rejunity/tt10-lgn-mnist/assets/final_20250113-141316_acc4865_seed775741_epochs50_dispersion16_8x1024.png

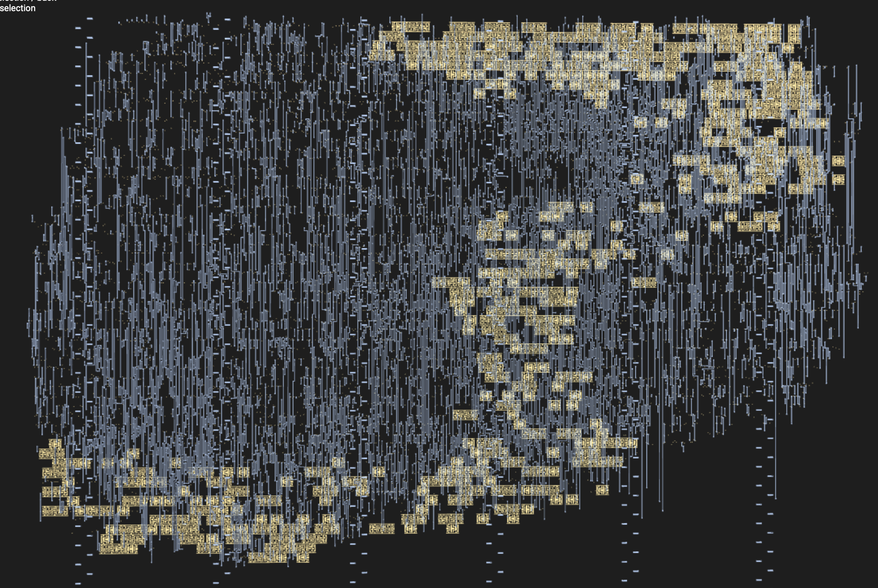
assets/final_20250113-141316_acc4865_seed775741_epochs50_dispersion16_8x1024.png
