rejunity/tt10-lgn-mnist/assets/final_20250114-102550_acc8068_seed1873_epochs300_dispersion64_1020-1020-1020-1020-1020-1020-1020-1020.png

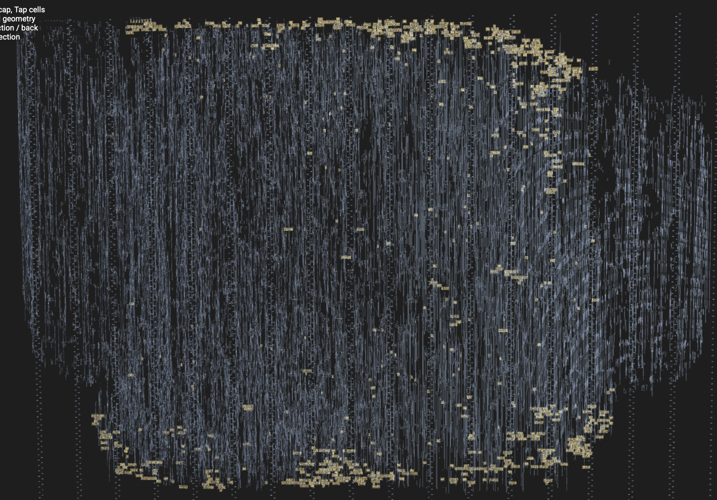
assets/final_20250114-102550_acc8068_seed1873_epochs300_dispersion64_1020-1020-1020-1020-1020-1020-1020-1020.png
