rejunity/tt10-lgn-mnist/src/net_testdata.v

// Generated from: 20250915-070516_binTestAcc9760_seed230646_epochs100_2x4000_b256_lr30_interconnect.npz

`default_nettype none
`timescale 1ns/1ps
`define TESTDATA_N 64
`define TESTDATA_X 256
`define TESTDATA_Y 2550
module net_testdata;
  parameter N = `TESTDATA_N;
  reg  [(`TESTDATA_X)-1:0] X [0:(`TESTDATA_N)-1];
  reg  [(`TESTDATA_Y)-1:0] Y [0:(`TESTDATA_N)-1];  
  initial begin
    X[0] = 256'b0000000000000000000000000111110000000000111111000000001110001100000001100000110000001100000011000001100000011000001100000001100000110000001100000011001000100000001100100110000000011111110000000001111110000000000011110000000000001100000000000000000000000000;
    X[1] = 256'b0000000000111000000000001111100000000000111110000000000001111000000000001111000000000001111100000000001111100000000000111100000000000111100000000000111100000000000011110000000000011110000000000011110000000000001111000000000000111000000000000011000000000000;
    X[2] = 256'b0000000000000000000000000000000000000011110000000000111111100000000111000011000000011100001100000001110000111000000111000011100000001100001100000000110000110000000011111100000000001111110000000000111111000000000011110000000000000000000000000000000000000000;
    X[3] = 256'b0000000001111000000000000111000000000000111000000000000111100000000000011100000000000011110000000000011110000000000011110000000000011110000000000001111000000000001111000010000000111111111100000011111111110000000000000110000000000000000000000000000000000000;
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
    X[38] = 256'b0000000001110000000000000111000000000000111000000000000111000000000000111000000000000111000000000000011100000000000011100000000000011100001111000011100111111100001111111111100001111111000000000111110000000000000000000000000000000000000000000000000000000000;
    X[39] = 256'b0000000001110000000000001111000000000001111000000000000111000000000000111000000000000111100000000000011000010000000011100001100000011100001110000011100001110000001110000111000000111110111000000001111111100000000000001000000000000000000000000000000000000000;
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

  end
endmodule
