rejunity/tt10-lgn-mnist/src/net.v

// Generated from: 20250915-070516_binTestAcc9760_seed230646_epochs100_2x4000_b256_lr30_interconnect.npz

module net (
    input  wire [253:0] in,
    output wire [3999:0] out,
    output wire [2549:0] categories
);
    wire [4000:0] layer_0;

    // Layer 0 ============================================================
    assign layer_0[0] = in[137] & ~in[53]; 
    assign layer_0[1] = ~(in[98] ^ in[85]); 
    assign layer_0[2] = ~(in[117] | in[88]); 
    assign layer_0[3] = in[88] ^ in[197]; 
    assign layer_0[4] = ~in[168] | (in[168] & in[163]); 
    assign layer_0[5] = ~(in[39] ^ in[134]); 
    assign layer_0[6] = ~(in[38] ^ in[66]); 
    assign layer_0[7] = ~(in[147] ^ in[149]); 
    assign layer_0[8] = ~(in[186] | in[63]); 
    assign layer_0[9] = in[131]; 
    assign layer_0[10] = ~(in[219] ^ in[251]); 
    assign layer_0[11] = in[138] & ~in[164]; 
    assign layer_0[12] = ~(in[101] | in[197]); 
    assign layer_0[13] = ~(in[138] | in[124]); 
    assign layer_0[14] = ~(in[153] ^ in[114]); 
    assign layer_0[15] = in[59]; 
    assign layer_0[16] = ~(in[242] | in[250]); 
    assign layer_0[17] = in[102] & ~in[113]; 
    assign layer_0[18] = ~(in[132] ^ in[166]); 
    assign layer_0[19] = in[250] ^ in[164]; 
    assign layer_0[20] = ~(in[103] ^ in[54]); 
    assign layer_0[21] = in[9]; 
    assign layer_0[22] = ~(in[219] | in[58]); 
    assign layer_0[23] = in[217] | in[77]; 
    assign layer_0[24] = in[154] & ~in[173]; 
    assign layer_0[25] = in[115]; 
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
    assign layer_0[2519] = ~(in[134] | in[75]); 
    assign layer_0[2520] = ~(in[189] ^ in[133]); 
    assign layer_0[2521] = ~in[171] | (in[134] & in[171]); 
    assign layer_0[2522] = ~(in[9] | in[68]); 
    assign layer_0[2523] = ~(in[63] ^ in[46]); 
    assign layer_0[2524] = ~(in[249] ^ in[235]); 
    assign layer_0[2525] = in[52] ^ in[83]; 
    assign layer_0[2526] = ~in[151] | (in[151] & in[214]); 
    assign layer_0[2527] = ~(in[141] ^ in[59]); 
    assign layer_0[2528] = in[231] ^ in[200]; 
    assign layer_0[2529] = ~in[118] | (in[118] & in[91]); 
    assign layer_0[2530] = in[105] & ~in[222]; 
    assign layer_0[2531] = in[229] | in[247]; 
    assign layer_0[2532] = ~in[215] | (in[215] & in[131]); 
    assign layer_0[2533] = in[116] | in[159]; 
    assign layer_0[2534] = in[188] ^ in[89]; 
    assign layer_0[2535] = in[116] | in[87]; 
    assign layer_0[2536] = in[59] | in[92]; 
    assign layer_0[2537] = ~(in[185] | in[115]); 
    assign layer_0[2538] = ~(in[198] ^ in[140]); 
    assign layer_0[2539] = ~in[137] | (in[213] & in[137]); 
    assign layer_0[2540] = in[150] | in[37];
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
