rejunity/tt10-lgn-mnist/src/npz_to_verilog.py

import sys
import os
import numpy as np
from collections.abc import Sequence, Mapping

# DONE: Inject additional pass-through (negate / or) gates on the long connections.
#       Use keep directive to avoid optimisastion by Yosys.
#       Predict wire length

# TODO: * %Warning-UNUSEDSIGNAL / predict gate count
#       * Fanout histogram

GENERATE_TESTBENCH_DATA = True

LIMIT_LONG_CONNECTIONS = False
# LIMIT_LONG_CONNECTIONS = 128

# ASSUME_CIRCULAR_LAYOUT_FOR_CONNECTION_LENGTH = False
ASSUME_CIRCULAR_LAYOUT_FOR_CONNECTION_LENGTH = True

# FORCE_RANDOM_GATES = [range(1, 14)]
# FORCE_TO_POWER_LAW = [.55, 0.1]

NEED_TO_PACK_STRIDED_OUTPUTS_INTO_CATEGORIES = False

NUMBER_OF_CATEGORIES = 10
OUTPUT_BITS_PER_CATEGORY = -1
# OUTPUT_BITS_PER_CATEGORY = 127
# OUTPUT_BITS_PER_CATEGORY = 255
# OUTPUT_BITS_PER_CATEGORY = 800
# OUTPUT_BITS_PER_CATEGORY = 1600

#... Verilog gen ..........................................................................

def op(gate_type, A, B):
    return [
        f"1'b0",
        f"{A} & {B}",
        f"{A} & ~{B}",
        f"{A}",
        f"{B} & ~{A}",
        f"{B}",
        f"{A} ^ {B}",
        f"{A} | {B}",
        f"~({A} | {B})",
        f"~({A} ^ {B})",
        f"~{B}",
        f"~{B} | ({A} & {B})",
        f"~{A}",
        f"~{A} | ({A} & {B})",
        f"~({A} & {B})",
        f"1'b1"
    ][gate_type]

def generate_verilog(global_inputs, gates, conn_a, conn_b, number_of_categories=NUMBER_OF_CATEGORIES, output_bits_per_category=OUTPUT_BITS_PER_CATEGORY):
    assert len(gates) == len(conn_a) == len(conn_b)
    global_outputs = len(gates[-1])

    decl = ""
    body = ""
    gate_idx = 0
    for layer_idx, layer_gates, layer_conn_a, layer_conn_b in zip(range(len(gates)), gates, conn_a, conn_b):
        if layer_idx > 0:
            decl += f"    wire [{len(gates[layer_idx-1])}:0] layer_{layer_idx-1};\n"
            input = f"layer_{layer_idx-1}"
        else:
            input = "in"

        if layer_idx < len(gates) - 1:
            output = f"layer_{layer_idx}"
        else:
            output = "out"

        assert len(layer_gates) == len(layer_conn_a) == len(layer_conn_b)
        body += f"    // Layer {layer_idx} ============================================================\n"

        idx = 0
        def setup_inputs(body, layer_idx, gate_idx, a, b):
            input_a = f"{input}[{a}]"
            input_b = f"{input}[{b}]"
            return body, input_a, input_b

        for out_idx, gate, a, b in zip(range(len(layer_gates)), layer_gates, layer_conn_a, layer_conn_b):
            body, input_a, input_b = setup_inputs(body, layer_idx, gate_idx, a, b)
            body += f"    assign {output}[{out_idx}] = {op(gate, f'{input_a}', f'{input_b}')}; \n"
            gate_idx += 1

    if number_of_categories > 0:
        body += f"    // Arrange outputs in categories ================================================\n"
        if output_bits_per_category < 0:
            output_bits_per_category = global_outputs // number_of_categories
        if NEED_TO_PACK_STRIDED_OUTPUTS_INTO_CATEGORIES:
            out_wires_per_category = global_outputs // number_of_categories
            for i in range(number_of_categories):
                out_lo = i * out_wires_per_category
                cat_lo = i * output_bits_per_category
                out_hi = out_lo + min(out_wires_per_category, output_bits_per_category) - 1
                cat_hi = cat_lo + min(out_wires_per_category, output_bits_per_category) - 1
                body += f"    assign categories[{cat_hi}:{cat_lo}] = out[{out_hi}:{out_lo}];\n"

                if (output_bits_per_category > out_wires_per_category):
                    cat_full = cat_lo + output_bits_per_category - 1
                    body += f"    assign categories[{cat_full}:{cat_hi + 1}] = 0;\n"
        else:
            body += f"    assign categories[{output_bits_per_category*number_of_categories-1}:0] = out[{output_bits_per_category*number_of_categories-1}:0];\n"

    return f"""
module net (
    input  wire [{ global_inputs-1}:0] in,
    output wire [{global_outputs-1}:0] out{"," if number_of_categories > 0 else ""}
    output wire [{number_of_categories*output_bits_per_category-1}:0] categories
);
{decl}
{body}
endmodule
"""

def generate_verilog_testdata(testdata_input, testdata_output, modulename="net"):
    X = testdata_input
    Y = testdata_output

    if X.shape[0] != Y.shape[0]:
        raise ValueError(f"input samples {X.shape[0]} != output samples {Y.shape[0]}")

    MAX_INPUT_SAMPLES = 64 # limit to 64 input samples for speed
    n = min(MAX_INPUT_SAMPLES, X.shape[0])
    in_w = X.shape[1]
    out_w = Y.shape[1]

    init_block = ""
    def array_to_bin(arr):
        return ''.join(arr.astype(int).astype(str))
    for i in range(n):
        init_block += f"    X[{i}] = {in_w }'b{array_to_bin(X[i][::-1])};\n"
    for i in range(n):
        init_block += f"    Y[{i}] = {out_w}'b{array_to_bin(Y[i][::-1])};\n"

    return f"""
`default_nettype none
`timescale 1ns/1ps
`define TESTDATA_N {n}
`define TESTDATA_X {in_w}
`define TESTDATA_Y {out_w}
module {modulename}_testdata;
  parameter N = `TESTDATA_N;
  reg  [(`TESTDATA_X)-1:0] X [0:(`TESTDATA_N)-1];
  reg  [(`TESTDATA_Y)-1:0] Y [0:(`TESTDATA_N)-1];  
  initial begin
{init_block}
  end
endmodule
"""


#... Misc utilities .......................................................................

def ascii_graph(values):
    # Array of characters for tiny histograms
    histogram_chars = np.array([
        " ","▁","▂","▃","▄","▅","▆","▇","▒","▓","█" 
    ])
    percentages = (values / values.sum()) * 100  # Normalize to 100%
    indices = (values * (len(histogram_chars) - 2)) // values.sum() + 1
    indices[percentages < 1] = 0
    return "".join(histogram_chars[indices]), percentages

def ascii_histogram(values, size=16):
    values = np.copy(values)
    values[values >= size] = size-1
    counts = np.zeros(size, dtype=int)
    for v in range(size):
        counts[v] = len(values[values == v])
    return ascii_graph(counts)

def ascii_histogram_compressed(values, bins=8):
    if bins > np.max(values):
        bins = np.max(values) + 1
    counts, _ = np.histogram(values, bins=bins)
    counts = np.pad(counts, bins-len(counts))
    return ascii_graph(counts)

def load_npz_file(file_name):
    if not file_name.endswith('.npz'):
        raise ValueError(f"The file '{file_name}' is not a .npz file.")

    if not os.path.isfile(file_name):
        raise FileNotFoundError(f"The file '{file_name}' does not exist.")

    try:
        data = np.load(file_name)
        print("File loaded successfully.")
        print("Contents:")
        for key in data.keys():
            print(f"{key}: {data[key].shape}, dtype={data[key].dtype}")
        return data
    except Exception as e:
        raise RuntimeError(f"Failed to load the .npz file: {e}")

def save_verilog_file(file_name, verilog):
    with open(file_name, "w") as f:
        f.write(verilog)

#--- CORE function ------------------------------------------------------------------------

def npz_to_verilog(data, max_layers=-1):
    gates = data['gate_types']
    conn_a = data['connections.A']
    conn_b = data['connections.B']

    if 'inputs' in data:
        inputs = data['inputs'].dim(-1)
    else:
        inputs = max(np.max(conn_a[0]), np.max(conn_b[0]))
    inputs = [inputs] + [len(g) for g in gates]

    try:
        print(f"OVER-WRITING gates with random distributed: {FORCE_RANDOM_GATES}")
        for i in range(len(gates)):
            try:
                idx = min(i, len(FORCE_RANDOM_GATES)-1)
                choice = FORCE_RANDOM_GATES[idx]
            except:
                choice = FORCE_RANDOM_GATES

            try:
                choice = np.arange(choice)
                if choice < 0:
                    continue
            except:
                choice = np.array(choice)
                pass

            r = np.random.randint(0, len(choice), size=len(gates[i]))
            gates[i] = choice[r]
    except:
        pass

    def get_conn_distance(conn_a, conn_b, in_count):
        d = np.abs(conn_a - conn_b)
        if ASSUME_CIRCULAR_LAYOUT_FOR_CONNECTION_LENGTH:
            d[d > in_count // 2] = in_count - d[d > in_count // 2]
        return d

    def wire_stats(conn_a, conn_b, in_count):
        d = get_conn_distance(conn_a, conn_b, in_count)
        return np.max(d), np.mean(d)

    try:
        print(f"OVER-WRITING conections with random distributed according to power exponent: {FORCE_TO_POWER_LAW}")
        assert conn_a.shape == conn_b.shape
        for i in range(len(conn_a)):
            try:
                idx = min(i, len(FORCE_TO_POWER_LAW)-1)
                alpha = FORCE_TO_POWER_LAW[idx]
            except:
                alpha = FORCE_TO_POWER_LAW
            size = len(conn_a[i])
            zipf_floats = np.pow(np.arange(1, inputs[i] + 1), -alpha)
            cutoff = np.max(zipf_floats) * 0.03 # 3 percent cutoff for long tail distribution of random values
            zipf_floats[zipf_floats <= cutoff] = 0
            zipf_probs = zipf_floats / zipf_floats.sum()  # Normalize
            wire_before = wire_stats(conn_a[i], conn_b[i], inputs[i])
            conn_a[i] = np.random.choice(inputs[i]-1,     size=size)
            conn_b[i] = np.random.choice(len(zipf_probs), size=size, p=zipf_probs) + conn_a[i]
            conn_b[i][conn_b[i] >= inputs[i]] -= inputs[i]
            wire_after  = wire_stats(conn_a[i], conn_b[i], inputs[i])
            print(f"longest/average before: {int(wire_before[0])}/{int(wire_before[1])} vs now: {int(wire_after[0])}/{int(wire_after[1])}")
    except:
        pass

    # inject input connections, if the first connectivity layer is missing
    assert len(conn_a) == len(conn_b)
    if (gates.shape[0] > conn_a.shape[0]):
        conn_a = np.vstack((np.zeros(len(gates[0]), dtype=conn_a.dtype), conn_a))
        conn_b = np.vstack((np.ones (len(gates[0]), dtype=conn_b.dtype), conn_b))

    # (optional) limit long connections
    if LIMIT_LONG_CONNECTIONS > 0:
        print(f"CLAMPING conections length to: {LIMIT_LONG_CONNECTIONS}")
        for a, b, x in zip(conn_a, conn_b, inputs):
            wire_before = wire_stats(a, b, x)
            d = get_conn_distance(a, b, x) - LIMIT_LONG_CONNECTIONS
            mask_right = np.logical_and(d >= 0, a < b)
            mask_left = np.logical_and(d >= 0, a > b)
            assert np.all(~(mask_right & mask_left))
            b[mask_right] = a[mask_right] + LIMIT_LONG_CONNECTIONS
            b[mask_left]  = a[mask_left]  - LIMIT_LONG_CONNECTIONS
            if ASSUME_CIRCULAR_LAYOUT_FOR_CONNECTION_LENGTH:
                b[b >= x] -= x
                b[b < 0] += x
            assert np.all(b >= 0)
            assert np.all(b < x)
            wire_after  = wire_stats(a, b, x)
            print(f"longest/average before: {int(wire_before[0])}/{int(wire_before[1])} vs now: {int(wire_after[0])}/{int(wire_after[1])}")


    # (optional) cut layers above max_layers
    assert len(gates) == len(conn_a) == len(conn_b)
    if max_layers > 0 and len(gates) > max_layers:
        layers_to_cut = len(gates) - max_layers
        print(f"Optional max_layers = {max_layers} parameter was specified, cutting the last {layers_to_cut} layer(s)!")
        gates = gates[:-layers_to_cut]
        conn_a = conn_a[:-layers_to_cut]
        conn_b = conn_b[:-layers_to_cut]
        print(f"There are {len(gates)} layers after cut.")

    print()
    print("Layer statistics:")
    print("   ","  _ _   ___ _ _ ")
    print("   ","0&⇒A⇐B⊕||⊕B⇐A⇒&1","   ","0...4..........16..............32.... connection distance .....>64")
    total_wire = 0
    total_gates = np.prod(gates.shape)
    for i, g, a, b, x in zip(range(len(gates)), gates, conn_a, conn_b, inputs):
        d = get_conn_distance(a, b, x)
        assert np.all(d >= 0)
        if ASSUME_CIRCULAR_LAYOUT_FOR_CONNECTION_LENGTH:
            assert np.all(d <= x // 2)
        print(f"{i:3}", ascii_histogram(g, size=16)[0], "   ", ascii_histogram(d, size=64)[0], "xx", ascii_histogram_compressed(d, bins=8)[0])
        total_wire += np.sum(d)
    print("   ","0&⇒A⇐B⊕||⊕B⇐A⇒&1")
    print(f"Total wire: {total_wire}, avg: {total_wire//total_gates}")
    print(f"Total gates: {total_gates}")
    input_count = np.max([np.max(conn_a[0,:]), np.max(conn_b[0,:])]) + 1
    return generate_verilog(input_count, gates, conn_a, conn_b)

###########################################################################################

if __name__ == "__main__":
    if len(sys.argv) != 2 and len(sys.argv) != 3:
        print(f"Usage: python {sys.argv[0]} <input_npz_file_name> <output_verilog_file_name> (optional: <max_layers>)")
        sys.exit(1)

    npz_file_name = sys.argv[1]
    if len(sys.argv) == 3:
        verilog_file_name = sys.argv[2]
    else:
        verilog_file_name = os.path.splitext(npz_file_name)[0] + ".v"
    max_layers = -1
    if len(sys.argv) > 3:
        max_layers = int(sys.argv[3])

    data = load_npz_file(npz_file_name)
    verilog = f"// Generated from: {npz_file_name}\n" + \
        npz_to_verilog(data, max_layers)

    save_verilog_file(verilog_file_name, verilog)
    print(f"Verilog code has been generated and saved to '{verilog_file_name}'.")


    if GENERATE_TESTBENCH_DATA and "input" in data and "output" in data:
        testbench_file_name = verilog_file_name[:-2] + "_testdata.v"
        testbench = f"// Generated from: {npz_file_name}\n" + \
            generate_verilog_testdata(data["input"], data["output"])
        save_verilog_file(testbench_file_name, testbench)
        print(f"Testbench has been generated and saved to '{testbench_file_name}'.")
