rejunity/tt10-lgn-mnist/(commit log)

2025-01-09 Bumped density to 98% and slower clock period (100ns = 10MHz) just in case
2025-01-09 20K gates - cut the last layer out
2025-01-09 16K gates - cut the last 2 layers out
2025-01-12 XOR case tests
2025-01-13 Stabilize randomness in gen_test_nets.py by resetting seed for every network
    [gen_test_nets.py]
2025-01-13 8 layer x 256 XOR gates, clamped to edge dispersion 16 & roll 0/1 connected
2025-01-13 8 layer x 256 XOR gates, clamped to edge dispersion 8 & roll 0/1 connected
2025-01-13 8 layer x 256 XOR gates, clamped to edge dispersion 4 & roll 0/1 connected
2025-01-14 Print nice histograms about gate types and connection lengths
2025-01-14 Small fix for very sparse nets
    [npz_to_verilog.py]
2025-01-15 Don't print padding message if padding was NOT necessary
2025-01-16 Test relay injection on the long connections with: tiles 4x4, target density 75, Barabasi, 8x1020, dispersion 128 (settings identical to commit: 085240a).
2025-01-16 Target density 76, Barabasi, 8x1020, dispersion 128, relay 32. Experiments to see if relay injection helps to get to higher density.
2025-01-16 Target density 80, Barabasi, 8x1020, dispersion 128, relay 32. Experiments to see if relay injection helps to get to higher density.
2025-01-16 Target density 85, Barabasi, 8x1020, dispersion 128, relay 32. Experiments to see if relay injection helps to get to higher density.
2025-01-17 (density=75) Had to rewrite nice far() function into an ugly module in order to instantiate sky130_fd_sc_hd__inv_1, otherwise flow does not respect "keep" directive and optimizes relay out.
2025-01-17 (density=75) Relay only one side (B) of the long connection to reduce the crazy amount of injected inverters.
2025-01-20 FPGA up5k compatible with iCEBreaker and PicoIce boards
2025-01-21 Increased RELAY_LONG_CONNECTIONS to 64, allow optimizer to take away the 2nd inverter in relay_conn
2025-01-21 Small fix for double .py in the usage
    [npz_to_verilog.py, pth_to_npz.py, pth_to_verilog.py]
2025-01-22 Print network architecture when importing .pth
2025-01-24 Print best value in dec
2025-01-24 FPGA: wrong clock signal
    [icebreaker.v]
2025-01-25 FPGA fixes after including popcount
    [icebreaker.v, popcount.v]
2025-01-30 Optional random initialisation of connections with power distribution for testing.
2025-06-09 (LF1270 96.11%) small fixes and temporarily disabled tests
    [net.v, project.v, test.py]
2025-06-09 LF1270 96.80% bin_test_acc, crop 24x24 -> 16x16 inputs. Also swapped OUT and BIDIR
    [project.v, test.py]
2025-06-09 updated info.yaml with pin description and more specific name
2025-06-09 fixed tests after swapped OUT and BIDIR
    [test.py]
2025-06-09 do not unnecessarily pad validation dataset_output tensors, otherwise tests fail due to incorrect reshape(10,...) when last layer has less elements than the other layers
    [pth_to_npz.py, test.py]
2025-06-09 Use seven segment display on the TT board to display a classified digit
2025-06-10 Training params for L2560F1270 97.46% bin_test_acc, crop 22x22 -> 16x16 inputs. Early stopping after 30 epochs. NOTE that previous commit had a mistake 'crop 24x24' while it should be 'crop 22x22'
    [TRAINING_PARAMS.txt]
2025-09-15 Fixed unnecessary strided assignment between outputs and summed categories, produced incorrect results when last layer had less elements than other layers.
    [npz_to_verilog.py]
2025-09-15 Perhaps after the strided out->categories fix we do not need approximate assert anymore
    [test.py]
2025-09-15 Tests: reversed the argmax order to match hardware implementation better
    [test.py]
2025-09-15 Updated TRAINING_PARAMS.txt for ttsky25b-tapeout tag
    [TRAINING_PARAMS.txt]
2026-01-30 1) Fixed support for compiled models - PyTorch injects "_orig_mod" in front of the tensor name 2) Added support for legacy layers writing "top_c" and "top_indices"
    [pth_to_npz.py]
2026-02-15 Fixed support for TopK layers which store all `indices` together with `top_c` and `top_indices`.
    [pth_to_npz.py]
2026-02-16 Shorter npz_to_verilog script, removed unused parts that only complicate code readability.
    [npz_to_verilog.py]
2026-02-17 Fixed exit error code in testbench
    [npz_to_verilog.py]
